MarcelMG/Photodiode_Amplifier/README.md

# Photodiode_Amplifier
digitally selectable variable gain transimpedance amplifier for photodiodes
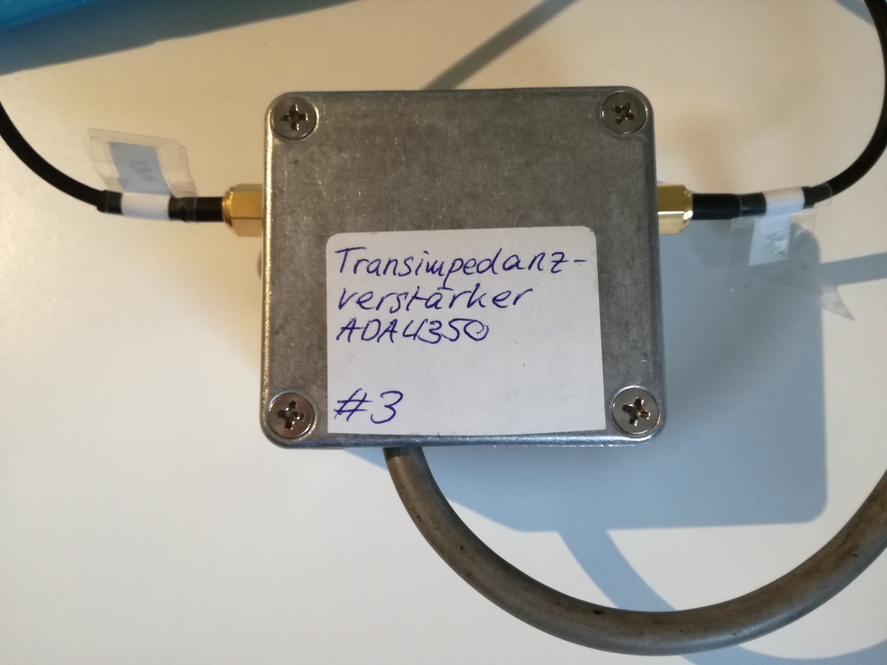
[picture p1: TIA_pic.jpg]

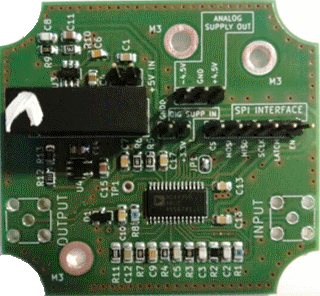
[picture p2: TIA_PCB.png]
pcb
