MarcelMG/Photodiode_Amplifier/CAD/CAD_FreeCAD.FCStd

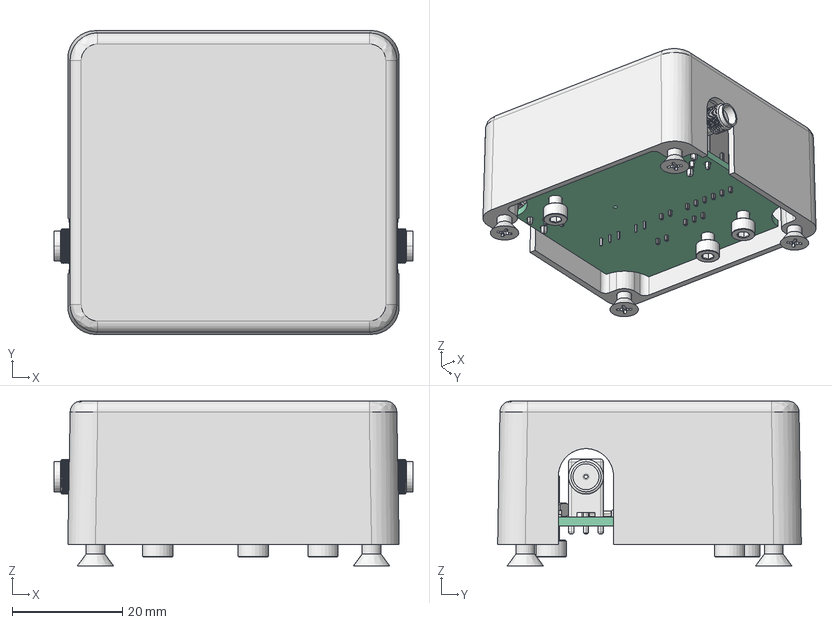
[picture p3: CAD file, 2019-11-06]
CAD/CAD_FreeCAD.FCStd
65.0 x 55.0 x 29.9 mm
Pcb
OUTPUT_C-5-1814400-1_5DBF4BDE
INPUT_C-5-1814400-1_5DBF4C02
C1_C_0805_2012Metric_5DBF4A7F
C2_C_0805_2012Metric_5DBF4A90
C3_C_0805_2012Metric_5DBF4AA1
C4_C_0805_2012Metric_5DBF4AB2
C5_C_0805_2012Metric_5DBF4AC3
C6_C_0805_2012Metric_5DBF4AD4
C7_C_0805_2012Metric_5DBF4AE5
C8_C_0805_2012Metric_5DBF4AF6
C9_C_0805_2012Metric_5DBF4B07
C10_C_0805_2012Metric_5DBF4B18
C11_C_0805_2012Metric_5DBF4B29
C12_C_0805_2012Metric_5DBF4B3A
C13_C_0805_2012Metric_5DBF4B4B
C14_C_0805_2012Metric_5DBF4B5C
C15_C_0805_2012Metric_5DBF4B6D
C16_C_0805_2012Metric_5DBF4B7E
C17_C_0805_2012Metric_5DBF4B8F
D1_SOT_23_5DBF4BA4
"+5V IN"_PinHeader_1x02_P254mm_Vertical_5DBF4BBA
"DIG SUPP IN"_PinHeader_1x02_P254mm_Vertical_5DBF4C18
+4.5V_PinHeader_1x03_P254mm_Vertical_5DBF4C2F
"SPI INTERFACE"_PinHeader_1x06_P254mm_Vertical_5DBF4C49
R1_R_0805_2012Metric_5DBF4C6C
R2_R_0805_2012Metric_5DBF4C7D
R3_R_0805_2012Metric_5DBF4C8E
R4_R_0805_2012Metric_5DBF4C9F
R5_R_0805_2012Metric_5DBF4CB0
R6_R_0805_2012Metric_5DBF4CC1
R7_R_0805_2012Metric_5DBF4CD2
R8_R_0805_2012Metric_5DBF4CE3
R9_R_0805_2012Metric_5DBF4CF4
R10_R_0805_2012Metric_5DBF4D05
R11_R_0805_2012Metric_5DBF4D16
R12_R_0805_2012Metric_5DBF4D27
R13_R_0805_2012Metric_5DBF4D38
tma-5&12vin
U2_TSSOP_28_44x97mm_P065mm_5DBF4D82
U3_SOT_23_6_5DBF4D98
U4_SOT_23_5_5DBF4DAD
SC1550 (screw M3.5-0.6X 12mm FH)
SC1550 (screw M3.5-0.6X 12mm FH)001
SC1550 (screw M3.5-0.6X 12mm FH)002
SC1550 (screw M3.5-0.6X 12mm FH)003
1550Q BOX CUT
