MarcelMG/Photodiode_Amplifier/PCB/schematic.pdf

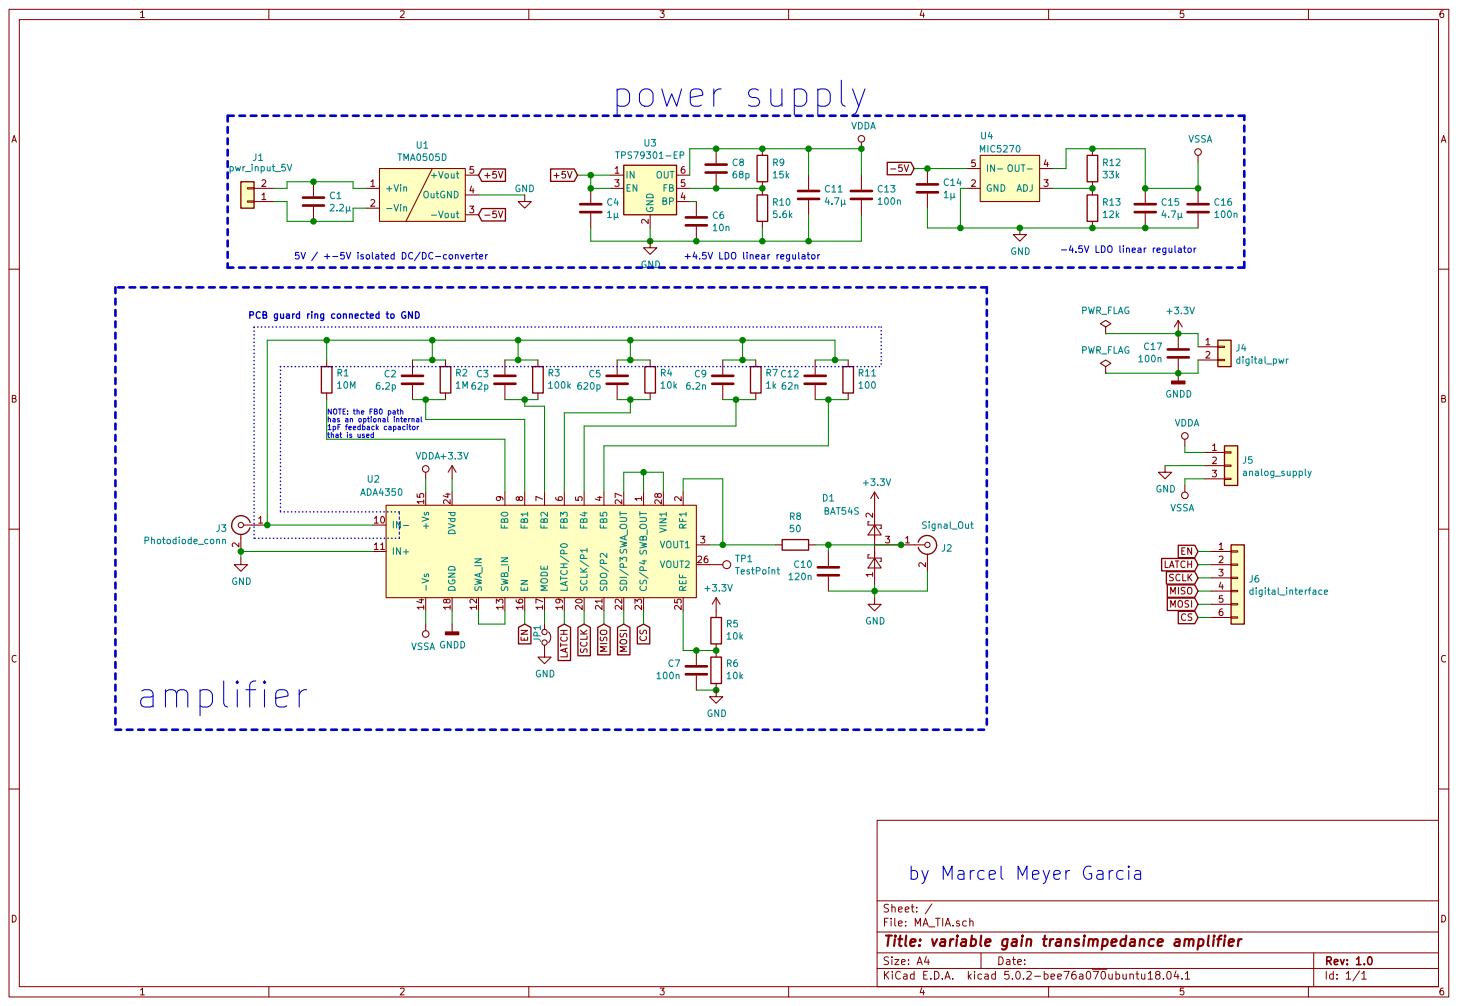
[picture p4: page 1]

2 EN 3 BP 4 FB 5 OUT 6 U3 TPS79301-EP GND 2 ADJ 3 OUT- 4

62n PCB guard ring connected to GND

NOTE: the FB0 path
has an optional internal 1pF feedback capacitor

2 SCLK/P1 20 SDO/P2 21 SDI/P3 22 CS/P4 23 DVdd 24 REF 25 VOUT2 26 SWA_OUT 27 VIN1 28 VOUT1 3 FB5

File: MA_TIA.sch Sheet: /
Id: 1/1 Title: variable gain transimpedance amplifier
