MarcelMG/Photodiode_Amplifier/Simulation/ADA4350_test.asc

ADC_supply: voltage; 3.3V
C1: cap; 62n
C2: cap; 1p
Cdiode: cap; 140p
D1: schottky; BAT54SHM
D2: schottky; BAT54SHM
Ip: current; ""; AC 100n
pwr+: voltage; 4.5V
pwr-: voltage; 4.5V
R1: res; 10Meg
R2: res; 50
R4: res; 10k
R5: res; 10k
Rshunt: res; 70k
U1: ADA4350
Named nets: 0, +5V, out, in-, in+, -5V, +3.3V
photodiode model
.ac dec 50 1 100k
