MarcelMG/Photodiode_Amplifier/PCB/MA_TIA.kicad_pcb

## KiCad design PCB/MA_TIA.kicad_pcb (2020-01-12)

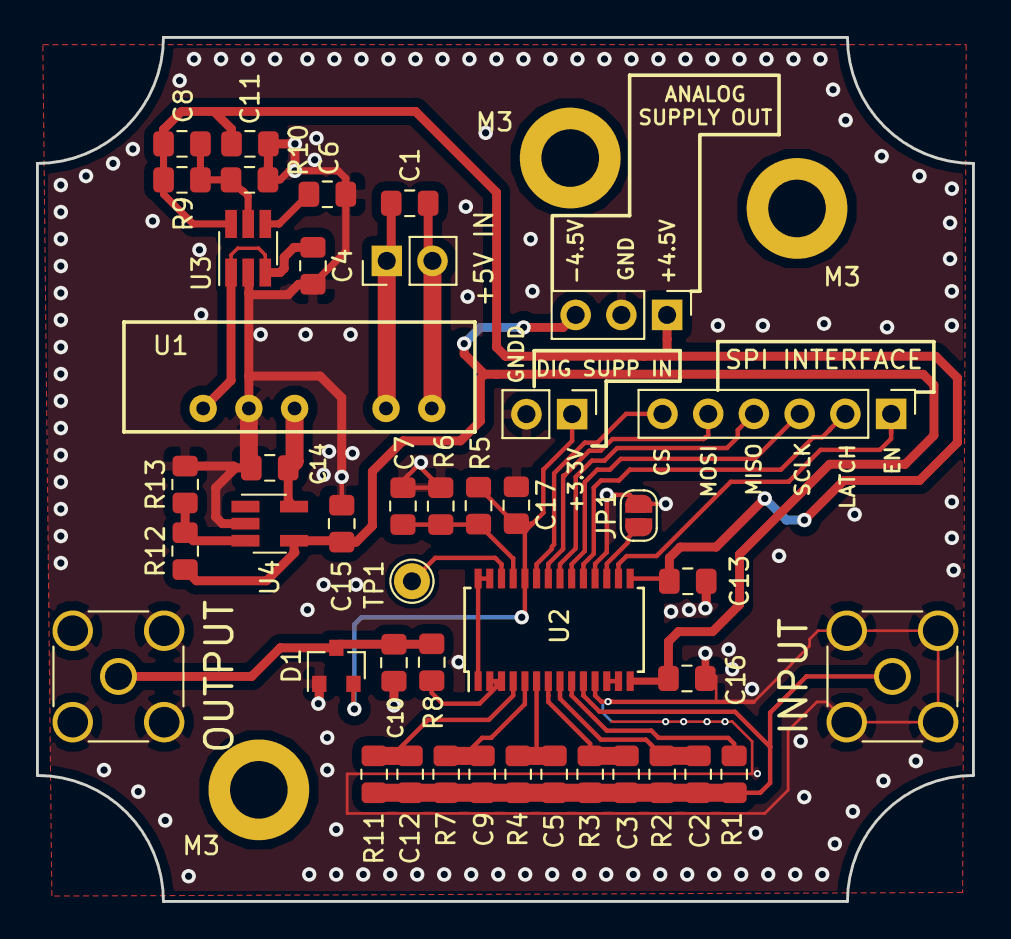
[picture p5: board MA_TIA.kicad_pcb from above]

Board: 2 copper layers, 52.0 x 48.0 mm, 46 parts (0 on the bottom side), 31 nets.

Parts:
+4.5V: analog_supply; PinHeader_1x03_P2.54mm_Vertical
+5V IN: pwr_input_5V; PinHeader_1x02_P2.54mm_Vertical
C1: 2.2µ; C_0805_2012Metric_Pad1.15x1.40mm_HandSolder
C2: 6.2p; C_0805_2012Metric_Pad1.15x1.40mm_HandSolder
C3: 62p; C_0805_2012Metric_Pad1.15x1.40mm_HandSolder
C4, C14: 1µ; C_0805_2012Metric_Pad1.15x1.40mm_HandSolder
C5: 620p; C_0805_2012Metric_Pad1.15x1.40mm_HandSolder
C6: 10n; C_0805_2012Metric_Pad1.15x1.40mm_HandSolder
C7, C13, C16, C17: 100n; C_0805_2012Metric_Pad1.15x1.40mm_HandSolder
C8: 68p; C_0805_2012Metric_Pad1.15x1.40mm_HandSolder
C9: 6.2n; C_0805_2012Metric_Pad1.15x1.40mm_HandSolder
C10: 120n; C_0805_2012Metric_Pad1.15x1.40mm_HandSolder
C11, C15: 4.7µ; C_0805_2012Metric_Pad1.15x1.40mm_HandSolder
C12: 62n; C_0805_2012Metric_Pad1.15x1.40mm_HandSolder
D1: BAT54S; SOT-23
DIG SUPP IN: digital_pwr; PinHeader_1x02_P2.54mm_Vertical
INPUT: Photodiode_conn; SMA_TE_5-1814400-1
JP1: SolderJumper-2_P1.3mm_Open_RoundedPad1.0x1.5mm
M3, M3#2, M3#3: MountingHole_3.2mm_M3_DIN965_Pad
OUTPUT: Signal_Out; SMA_TE_5-1814400-1
R1: 10M; R_0805_2012Metric_Pad1.15x1.40mm_HandSolder
R2: 1M; R_0805_2012Metric_Pad1.15x1.40mm_HandSolder
R3: 100k; R_0805_2012Metric_Pad1.15x1.40mm_HandSolder
R4, R5, R6: 10k; R_0805_2012Metric_Pad1.15x1.40mm_HandSolder
R7: 1k; R_0805_2012Metric_Pad1.15x1.40mm_HandSolder
R8: 50; R_0805_2012Metric_Pad1.15x1.40mm_HandSolder
R9: 15k; R_0805_2012Metric_Pad1.15x1.40mm_HandSolder
R10: 5.6k; R_0805_2012Metric_Pad1.15x1.40mm_HandSolder
R11: 100; R_0805_2012Metric_Pad1.15x1.40mm_HandSolder
R12: 33k; R_0805_2012Metric_Pad1.15x1.40mm_HandSolder
R13: 12k; R_0805_2012Metric_Pad1.15x1.40mm_HandSolder
SPI INTERFACE: digital_interface; PinHeader_1x06_P2.54mm_Vertical
TP1: TestPoint; TestPoint_THTPad_D2.0mm_Drill1.0mm
U1: TMA0505D
U2: ADA4350; TSSOP-28_4.4x9.7mm_P0.65mm
U3: TPS79301-EP; SOT-23-6_Handsoldering
U4: MIC5270; SOT-23-5_HandSoldering

Connections:
+3V3: C17.2, D1.2, DIG SUPP IN.1, R5.2, U2.24
+5V: C4.1, U1.5, U3.1, U3.3
-5V: C14.1, U1.3, U4.5
CS: SPI INTERFACE.6, U2.23
EN: SPI INTERFACE.1, U2.16
GND: +4.5V.2, C4.2, C6.2, C7.1, C10.1, C11.2, C13.2, C14.2, C15.2, C16.2, C17.1, D1.1, DIG SUPP IN.2, INPUT.2, JP1.2, OUTPUT.2, R6.1, R10.2, R13.2, U1.4, U2.11, U2.18, U3.2, U4.2
LATCH: SPI INTERFACE.2, U2.19
MISO: SPI INTERFACE.4, U2.21
MOSI: SPI INTERFACE.5, U2.22
unnamed: +5V IN.2, C1.1, U1.1
unnamed: +5V IN.1, C1.2, U1.2
unnamed: C2.2, R2.1, U2.8
unnamed: C3.2, R3.1, U2.7
unnamed: C5.2, R4.1, U2.6
unnamed: C6.1, U3.4
unnamed: C7.2, R5.1, R6.2, U2.25
unnamed: C8.2, R9.2, R10.1, U3.5
unnamed: C9.2, R7.1, U2.5
unnamed: C10.2, D1.3, OUTPUT.1, R8.2
unnamed: C2.1, C3.1, C5.1, C9.1, C12.1, INPUT.1, R1.2, R2.2, R3.2, R4.2, R7.2, R11.2, U2.10
unnamed: C12.2, R11.1, U2.4
unnamed: JP1.1, U2.17
unnamed: R1.1, U2.9
unnamed: R8.1, U2.2, U2.3
unnamed: R12.2, R13.1, U4.3
unnamed: TP1.1, U2.26
unnamed: U2.1, U2.27, U2.28
unnamed: U2.12, U2.13
SCLK: SPI INTERFACE.3, U2.20
VDDA: +4.5V.1, C8.1, C11.1, C13.1, R9.1, U2.15, U3.6
VSSA: +4.5V.3, C15.1, C16.1, R12.1, U2.14, U4.4
