MarcelMG/Photodiode_Amplifier/(commit log)

2019-11-06 moved two mountig holes slightly inwards
    [MA_TIA.kicad_pcb, MA_TIA_CAD.FCStd]
2020-01-12 fix: removed separate digital ground
    fix: removed separate digital ground (GNDD) and connected it to GND
    [MA_TIA.kicad_pcb, MA_TIA.sch]
2020-01-27 reorganized directory structure
    [CAD_FreeCAD.FCStd, MA_TIA.kicad_pcb, MA_TIA.sch]
